mwezi2k8/pinchy/art/previews/project_final.png

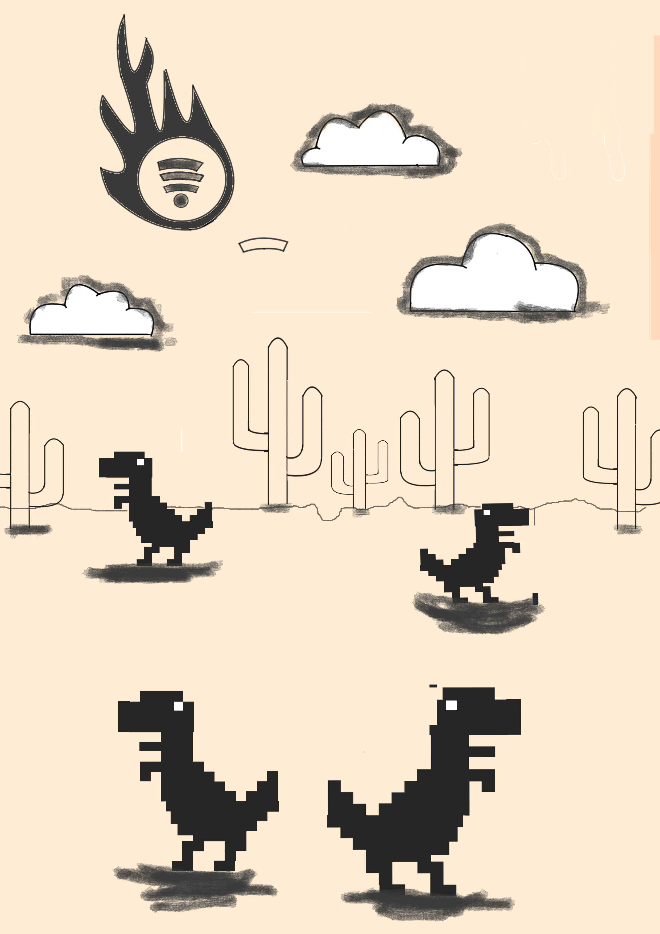
art/previews/project_final.png
