mwezi2k8/pinchy/art/previews/treasure_art1.png

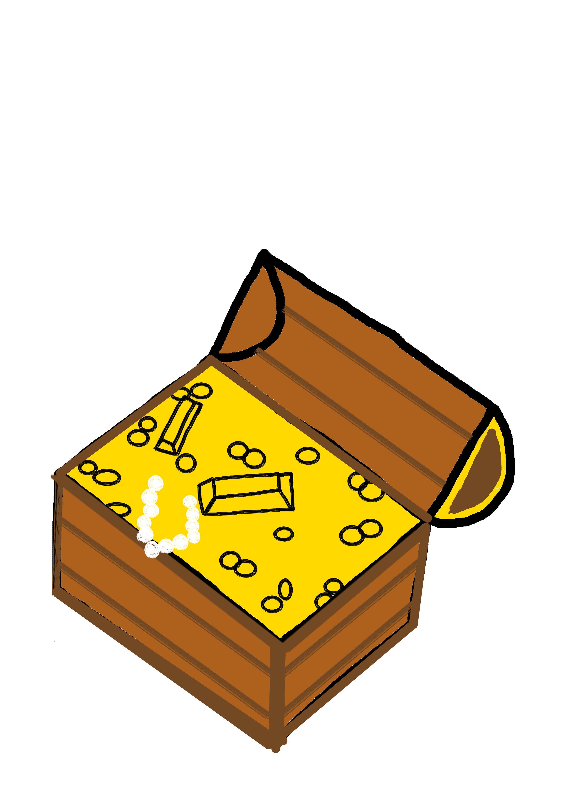
art/previews/treasure_art1.png
