mwezi2k8/pinchy/art/previews/treasure_art_2.png

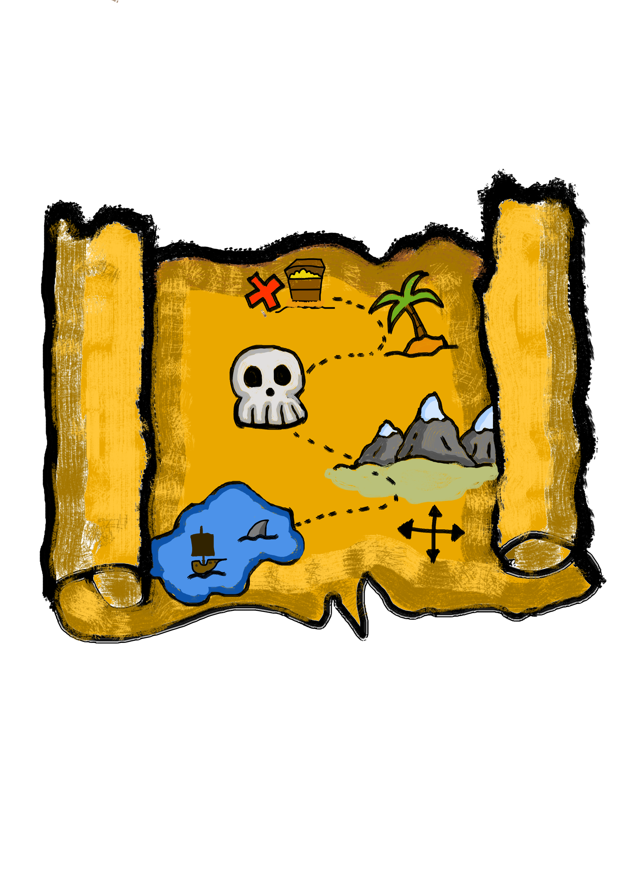
art/previews/treasure_art_2.png
