mwezi2k8/pinchy/art/previews/treasure_art_3.png

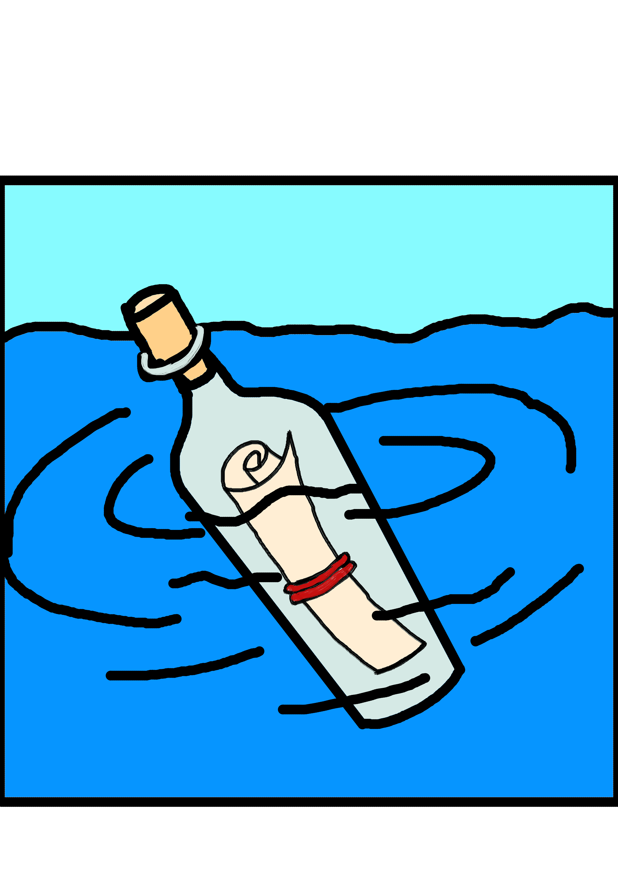
art/previews/treasure_art_3.png
