mwezi2k8/pinchy/CAD/STEP/arm_assembly_without_gripper.step

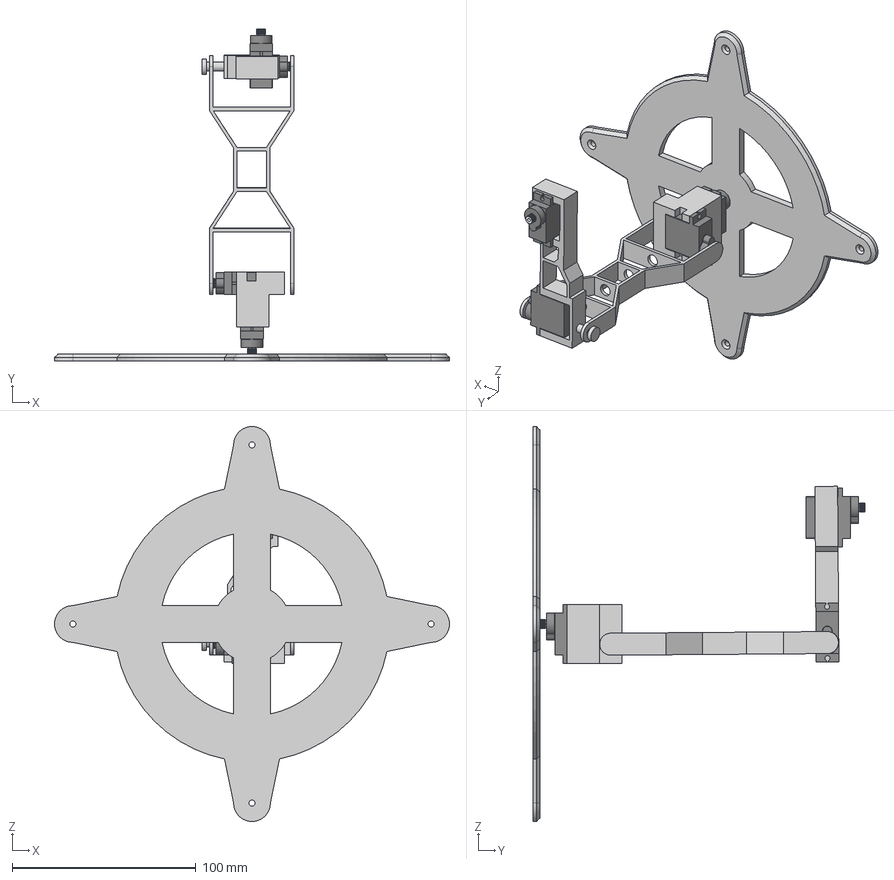
[picture p16: CAD file, 2026-11-01]
CAD/STEP/arm_assembly_without_gripper.step
215.1 x 180.9 x 215.1 mm
MG90S Servo Motor x 4
