mwezi2k8/pinchy/CAD/STEP/gripper.step

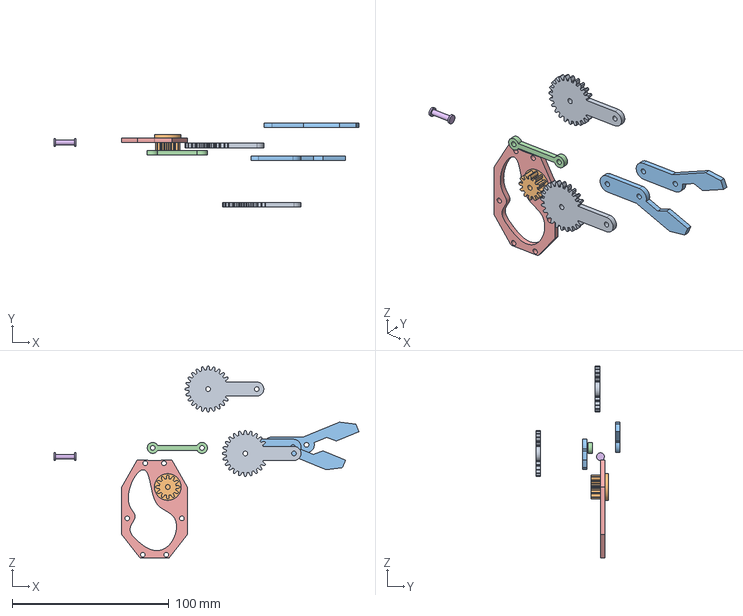
[picture p17: CAD file, 2026-11-01]
CAD/STEP/gripper.step
194.3 x 53.5 x 122.2 mm
