mwezi2k8/pinchy/CAD/STEP/mg90s_servo_reference.step

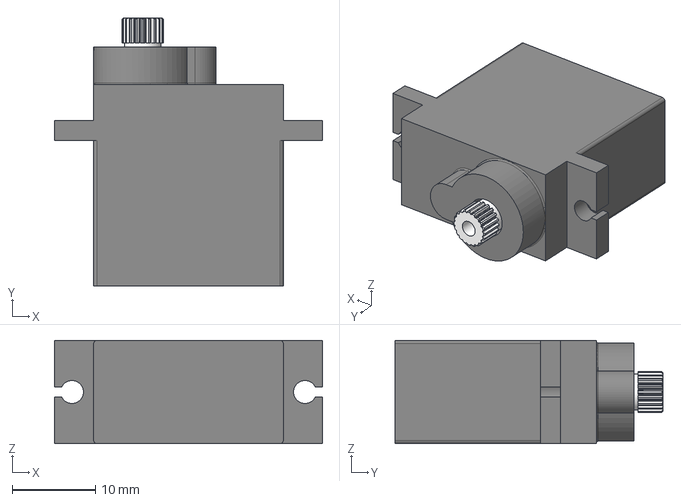
[picture p18: CAD file, 2026-11-01]
CAD/STEP/mg90s_servo_reference.step
32.2 x 32.2 x 12.4 mm
