mwezi2k8/pinchy/CAD/STEP/base_plate.step

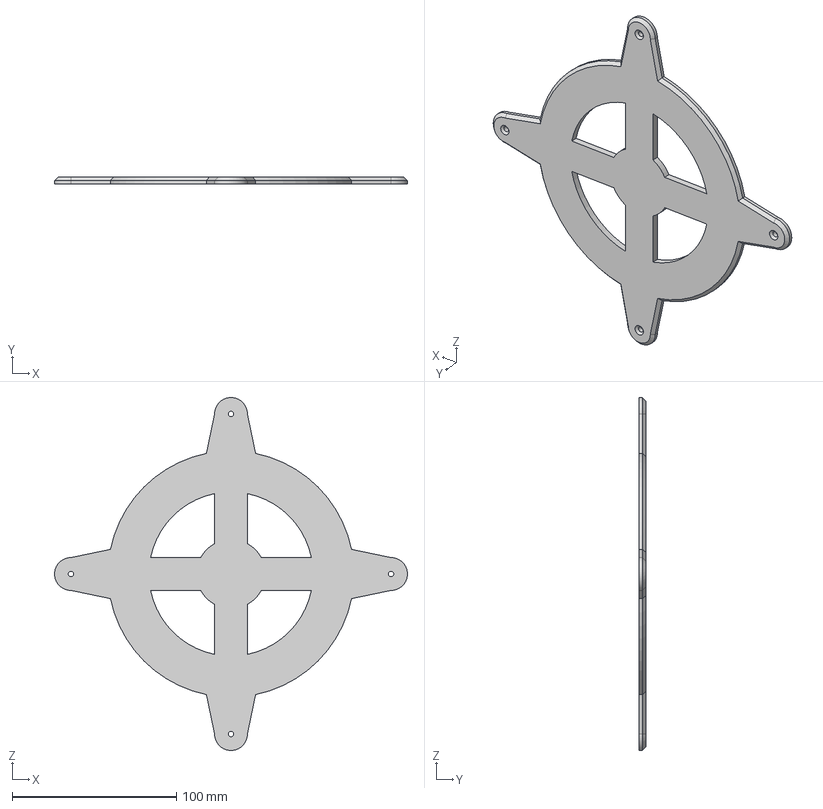
[picture p19: CAD file, 2026-11-01]
CAD/STEP/base_plate.step
215.1 x 4.00 x 215.1 mm
