mwezi2k8/pinchy/(list of files, cad)

Other CAD files:
CAD/STEP/pinchy.f3z
