mwezi2k8/pinchy/Wiring/receiver/pinchy_rx.kicad_sch

## KiCad design Wiring/receiver/pinchy_rx.kicad_sch (2026-11-01)

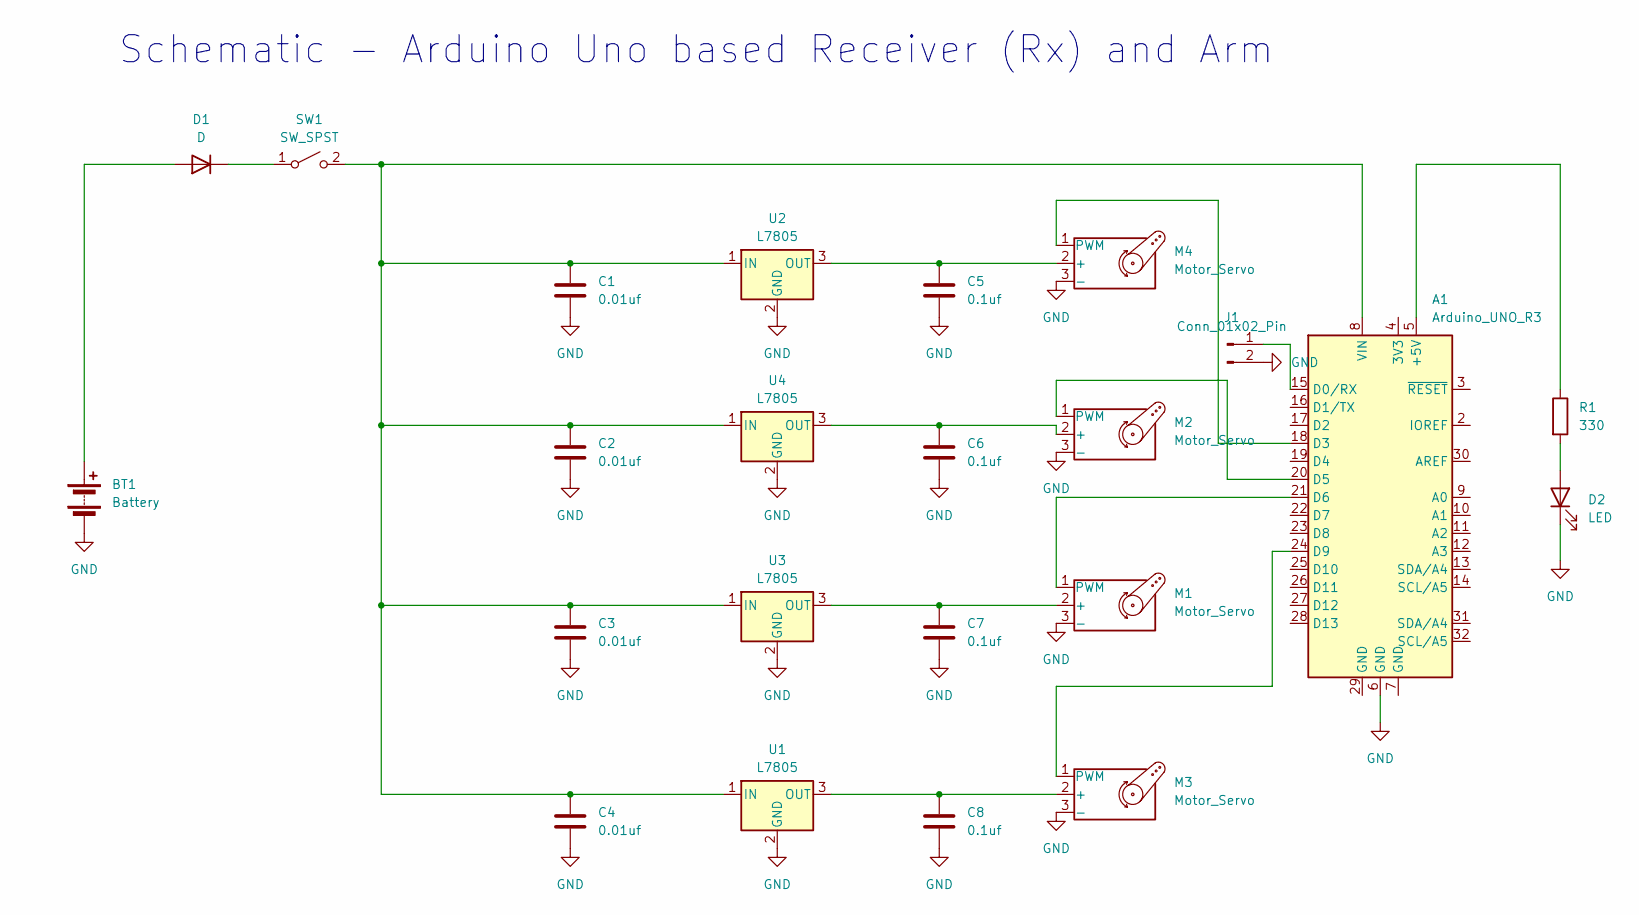
[picture p31: schematic pinchy_rx.kicad_sch]

Parts:
A1: Arduino_UNO_R3
BT1: Battery; Arduino_UNO_R3
C1, C2, C3, C4: 0.01uf
C5, C6, C7, C8: 0.1uf
D1: D
D2: LED
J1: Conn_01x02_Pin
M1, M2, M3, M4: Motor_Servo
R1: 330
SW1: SW_SPST
U1, U2, U3, U4: L7805

Connections:
GND: A1.6 (GND), BT1.2 (-), C1.2, C2.2, C3.2, C4.2, C5.2, C6.2, C7.2, C8.2, D2.1 (K), J1.2, M1.3 (-), M2.3 (-), M3.3 (-), M4.3 (-), U1.2 (GND), U2.2 (GND), U3.2 (GND), U4.2 (GND)
unnamed: A1.5 (+5V), R1.1
unnamed: A1.8 (VIN), C1.1, C2.1, C3.1, C4.1, SW1.2 (B), U1.1 (IN), U2.1 (IN), U3.1 (IN), U4.1 (IN)
unnamed: A1.15 (D0/RX), J1.1
unnamed: A1.18 (D3), M4.1 (PWM)
unnamed: A1.20 (D5), M2.1 (PWM)
unnamed: A1.21 (D6), M1.1 (PWM)
unnamed: A1.24 (D9), M3.1 (PWM)
unnamed: BT1.1 (+), D1.2 (A)
unnamed: C5.1, M4.2 (+), U2.3 (OUT)
unnamed: C6.1, M2.2 (+), U4.3 (OUT)
unnamed: C7.1, M1.2 (+), U3.3 (OUT)
unnamed: C8.1, M3.2 (+), U1.3 (OUT)
unnamed: D1.1 (K), SW1.1 (A)
unnamed: D2.2 (A), R1.2

Notes on the sheet:
Schematic - Arduino Uno based Receiver (Rx) and Arm
