mwezi2k8/pinchy/Wiring/transmitter/pinchy_tx.kicad_sch

## KiCad design Wiring/transmitter/pinchy_tx.kicad_sch (2026-11-01)

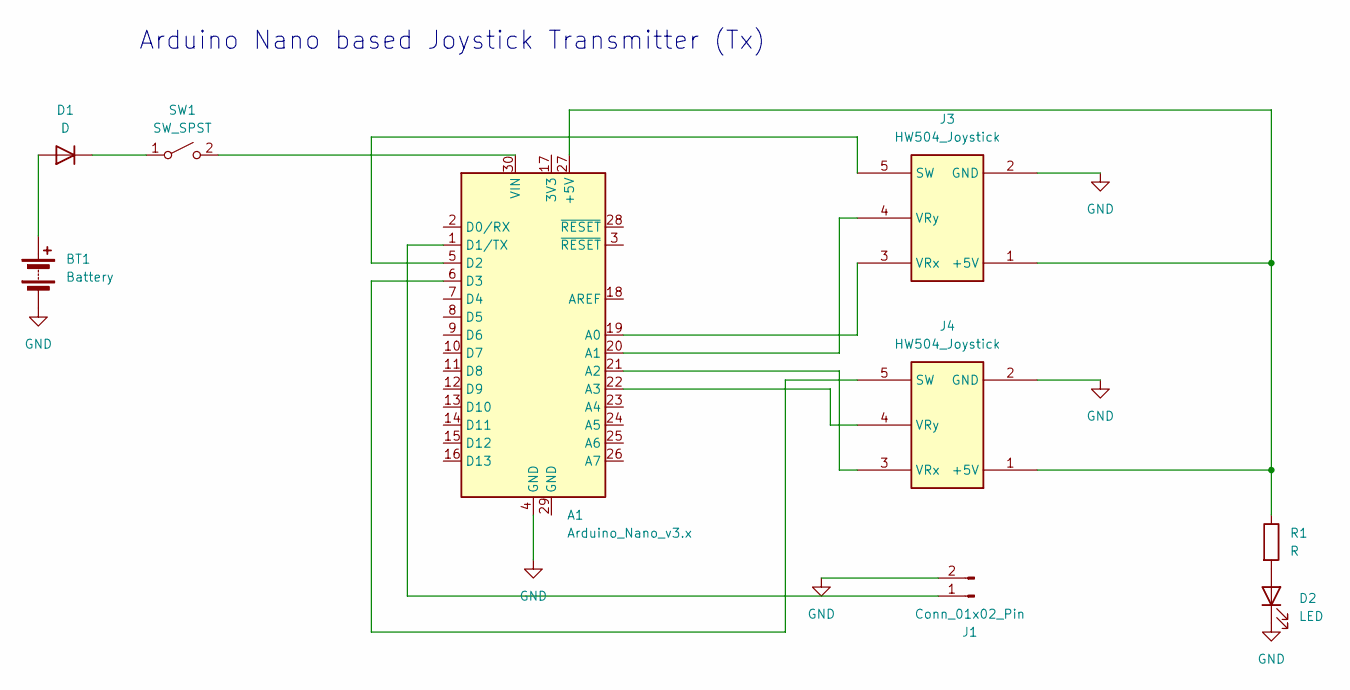
[picture p32: schematic pinchy_tx.kicad_sch]

Parts:
A1: Arduino_Nano_v3.x; Arduino_Nano
BT1: Battery
D1: D
D2: LED
J1: Conn_01x02_Pin
J3, J4: HW504_Joystick; Joystick_HW504_1x05_P2.54mm
R1: R
SW1: SW_SPST

Connections:
GND: A1.4 (GND), BT1.2 (-), D2.1 (K), J1.2, J3.2 (GND), J4.2 (GND)
unnamed: A1.1 (D1/TX), J1.1
unnamed: A1.5 (D2), J3.5 (SW)
unnamed: A1.6 (D3), J4.5 (SW)
unnamed: A1.19 (A0), J3.3 (VRx)
unnamed: A1.20 (A1), J3.4 (VRy)
unnamed: A1.21 (A2), J4.3 (VRx)
unnamed: A1.22 (A3), J4.4 (VRy)
unnamed: A1.27 (+5V), J3.1 (+5V), J4.1 (+5V), R1.1
unnamed: A1.30 (VIN), SW1.2 (B)
unnamed: BT1.1 (+), D1.2 (A)
unnamed: D1.1 (K), SW1.1 (A)
unnamed: D2.2 (A), R1.2

Notes on the sheet:
Arduino Nano based Joystick Transmitter (Tx)
