mwezi2k8/pinchy/(commit log)

2026-11-01 Uploading all files
    [BOM.csv, arm_assembly_without_gripper.step, base_plate.step, gripper.step, mg90s_servo_reference.step, pinchy_rx.kicad_sch, pinchy_tx.kicad_sch]
2026-11-01 uploading fusion source
    [pinchy.f3z]
